TopherMan/Ramps2Due/Ramps2Due.sch

## KiCad design Ramps2Due.sch (2013-03-05)

Schematic: Ramps2Due.sch

Parts:
C1, C2: 100n
J1, J10: HEADER_2X2
J2: HEADER_3X2
J3, J4, J5, J8, J9, J11, J13, J14: HEADER_8
J6: HEADER_16X2
J7, J12: HEADER_10
J15: HEADER_7
J16: HEADER_2
M1: LOGO_OSHW; OSHW_logo_2
R1, R2, R3: 1k
U1: TXS0108
U2, U3, U4: ZXGD3005E6; SOT26

Notes on the sheet:
Note: This will connect to SparkFun's MicroSD Breakout board so I don't have to solder those inaccessible SD tabs
MicroSD Connector
Mosfets and Power
Logic Level Converter
To RAMPS
Note: This header goes at the top of the 2X18 on the Due
To Due
Unaltered Headers
