TopherMan/Ramps2Due/(commit log)

2013-02-28 Add Libraries from bobc_hardware, write initial version of scematic modeled after bobc's RIB
    [Ramps2Due.sch]
2013-02-28 Added values, minor changes
    [Ramps2Due.sch]
2013-02-28 Added SD card
    [Ramps2Due.sch]
2013-02-28 Switched SD to pin header, so I can use Sparkfun's breakout board for soldering ease
    [Ramps2Due.sch]
2013-02-28 Generated netlist, completed initial associations
    [Ramps2Due.sch]
2013-02-28 Custom footprints finished and net completed
2013-02-28 Begin board layout
    [Ramps2Due.brd]
2013-02-28 Typo with FET outputs.
    [Ramps2Due.brd, Ramps2Due.sch]
2013-02-28 All the tracts added (I think)
    [Ramps2Due.brd, Ramps2Due.sch]
2013-02-28 Add Open-Source Hardware logo, shrink board edges, remove extraneous tracts.
    [Ramps2Due.brd, Ramps2Due.sch]
2013-03-01 Fixed issue with back solder mask pads.
    [Ramps2Due.brd]
2013-03-01 Added spot for 5V pins to power endstops.
    [Ramps2Due.brd, Ramps2Due.sch]
2013-03-05 Rev0 complete. Sent to SeeedStudio for fabrication. Additionally, BOM added with suggested Digikey part numbers.
    [Ramps2Due.brd, Ramps2Due.sch]
2013-03-23 Added correct Digikey part number for 16x2 long pin header
2013-03-23 Fixed layout to use correct damn placement of the headers.
    [Ramps2Due.brd]
2013-03-23 Rev 1 gerbers created and sent to Seeedstudio.
2013-04-26 Update README to note that the board has been tested.
2013-04-30 Add some assembly tips.
